evschell/iot4ag-lorawan-adc-buffer/README.md

# iot4ag-lorawan-adc-buffer
ADC buffer for the Dragino LoRaWAN module
