evschell/iot4ag-lorawan-adc-buffer/sim/circuit_sim.asc

C1: cap; 10n
D1: TVSdiode
D2: TVSdiode
D3: TVSdiode
R1: res; 10k
R2: res; 10
R9: res; 100k
Rgain: res; 68k
RL: res; 40k
U1: AD8226
U2: AD8618
U3: ADP151-3.3
V1: voltage; 1.4
V2: voltage; 5
Named nets: Vin+, Vin-, Vcc, 0, RG+, RG-, Vout, VADC
.dc V1 0.01 3.5 0.1
