evschell/iot4ag-lorawan-adc-buffer/(commit log)

2023-04-18 First version of KiCad design
    [UPenn_OpAmp.kicad_pcb, UPenn_OpAmp.kicad_sch]
2023-04-18 Updating the pcb
    [UPenn_OpAmp.kicad_pcb, UPenn_OpAmp.kicad_sch]
2023-04-21 Fixes to PCB mounting holes
    [UPenn_OpAmp.kicad_pcb, UPenn_OpAmp.kicad_sch]
2023-04-21 Use individual vias
    [UPenn_OpAmp.kicad_pcb]
2023-04-21 Added some silk
    [UPenn_OpAmp.kicad_pcb]
2023-04-25 Update the PCB for three channels
    [UPenn_OpAmp.kicad_pcb, UPenn_OpAmp.kicad_sch]
2023-04-26 Update before fabrication
    [UPenn_OpAmp.kicad_pcb]
2023-04-26 Update of logos and distances
    [UPenn_OpAmp-B_Cu.gbr, UPenn_OpAmp-B_Mask.gbr, UPenn_OpAmp-B_Paste.gbr, UPenn_OpAmp-B_Silkscreen.gbr, UPenn_OpAmp-CuBottom.gbr, UPenn_OpAmp-CuTop.gbr, UPenn_OpAmp-EdgeCuts.gbr, UPenn_OpAmp-Edge_Cuts.gbr]
2023-05-11 Pin arrangement fixes and component upgrades
    [UPenn_OpAmp.kicad_pcb, UPenn_OpAmp.kicad_sch]
2023-05-11 minor cosmetic changes and fixed pcb version number
    [UPenn_OpAmp.kicad_pcb]
2023-05-11 fixed another little nitpick
    [UPenn_OpAmp.kicad_pcb]
2023-06-21 Ground issue fixed
    [UPenn_OpAmp.kicad_pcb, UPenn_OpAmp.kicad_sch, UPenn_OpAmp.step]
2023-06-26 Change of jumpers to dip switches
    [UPenn_OpAmp.kicad_pcb, UPenn_OpAmp.kicad_sch, UPenn_OpAmp.step]
2023-06-26 some good final touches
    [UPenn_OpAmp.kicad_pcb, UPenn_OpAmp.kicad_sch]
2023-06-26 deleted kicad backups
2023-07-14 Fix the power plane issue
    [UPenn_OpAmp.kicad_pcb]
